QuZeTianXia/Origin-pi/README.md

# Origin-pi 

The First Attempt at Linux Development Board  
## 项目介绍 
    依托荔枝派zero和snail_card项目构建基于linux的卡片电脑。
## 更新日志 
+ 2024/3/31/10:28   
   硬件部分完成第一版，已下单嘉立创加工。着手采购器件。 ~~（这次几乎全都要买了）~~
