QuZeTianXia/Origin-pi/Hardware/PCB/Origin_pi/Origin_pi.PcbDoc.htm

Reporting Options

# File in Newer Format

Date | : | 2024/3/30
Time | : | 20:35:30
Filename | : | E:\Tech file\linux-board\Origin-pi\Hardware\PCB\Origin_pi\Origin_pi.PcbDoc

Version | Warning
Release 17.0 | CAUTION - Component parameters added.
Release 17.0 | CAUTION - Support of backdrilling
Release 17.1 | CAUTION - Support of waived violations
Release 17.1 | CAUTION - Support of object specific keepouts
Release 20.0 | CAUTION - Support of propagation delay for primitives

This file was generated by a later version of the software
