QuZeTianXia/Origin-pi/docs/f1c200s环境搭建记录.md

# 一、交叉编译环境  
> 这里使用了WSL作为开发环境，不知道会不会有什么问题   
* 需要安装交叉编译工具链
