QuZeTianXia/Origin-pi/pic/Linux.bmp

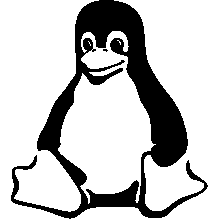
pic/Linux.bmp
