QuZeTianXia/Origin-pi/docs/BOM_SnailCard_v3s.xlsx

ID | Name | Designator | Footprint | Quantity
1 | 100nF | C13,C39,C1,C2,C3,C4,C5,C7,C8,C10,C11,C12,C21,C25,C27,C28,C29,C32,C37,C47,C52,C53,C54,C55,C56,C57,C58,C59,C30,C34 | C0603 | 30
2 | 15pF | C17,C18,C19,C20 | C0603 | 4
3 | 10uF | C22,C23,C40,C41,C6,C14,C15,C24,C31,C38,C43,C44,C45,C46,C33,C35 | C0603 | 16
4 | 1uF | C42,C9 | C0603 | 2
5 | 10K | R3,R8,R11,R29,R4,R5,R7,R12,R13,R14,R17,R19,R20,R21,R22,R24,R25,R26 | R0603 | 18
6 | 240 | R9 | R0603 | 1
7 | 6K | R15 | R0603 | 1
8 | 200K | R23,R6 | R0603 | 2
9 | ST-1185S | RSET | SW-SMD_ST-1185S | 1
10 | V3S | V3S | QUAD128 | 1
11 | 24MHz | X1 | OSC-SMD_4P-L3.2-W2.5-BL | 1
12 | 32.768KHz | X2 | OSC-SMD_L3.2-W1.5 | 1
13 | 4.7uF | C48,C16 | C0603 | 2
14 | 2.2uH | L2,L3,L4 | L0805 | 3
15 | TC5050RGBF08-3CJH-AF53A | LED | LED-SMD_6P-L5.0-W5.0-TL_TC5050RGBF08 | 1
16 | D-G080508G1 | POWER | LED0805-RD | 1
17 | TYPE-C-31-M-12 | POWER/TTL | USB-C_SMD-TYPE-C-31-M-12 | 1
18 | 2.2K | R1,R2 | R0603 | 2
19 | 680K | R10 | R0603 | 1
20 | 470 | R16,R18 | R0603 | 2
21 | 150K | R27,R28,R33,R34 | R0603 | 4
22 | 2K | R30,R35,R36 | R0603 | 3
23 | 300K | R32 | R0603 | 1
24 | XC6206-3.0V | U2 | SOT-23 | 1
25 | CH340E | U3 | MSOP-10_L3.0-W3.0-P0.50-LS5.0-BL | 1
26 | SY8088AAC | U4,U5,U8 | SOT-23-5_L3.0-W1.7-P0.95-LS2.8-BR | 3
27 | TLC-NSMD005 | U7 | R1206 | 1
28 | 1uF | C26 | CAP-SMD_L3.5-W2.8-R-RD | 1
29 | 104 | C36 | C0603 | 1
30 | CK3.5-20-1 | CN1 | AUDIO-SMD_CK3.5-20-1 | 1
31 | AN2051-245 | L1 | ANT2051 | 1
32 | 22R | R31 | R0603 | 1
33 | SD | SD2 | TF-SMD_TF-115K | 1
34 | 中景园2.0寸TFT12PIN焊接 | U1 | 中景园2.0 TFT 12PIN_0.8MM | 1
35 | RTL8723BS_Module | U12 | RTL8723BS_MODULE | 1
36 | USB-A | USB/OTG | USB-A | 1
