QuZeTianXia/Origin-pi/Hardware/Libriarys/3Ds/R0603-1.SLDPRT

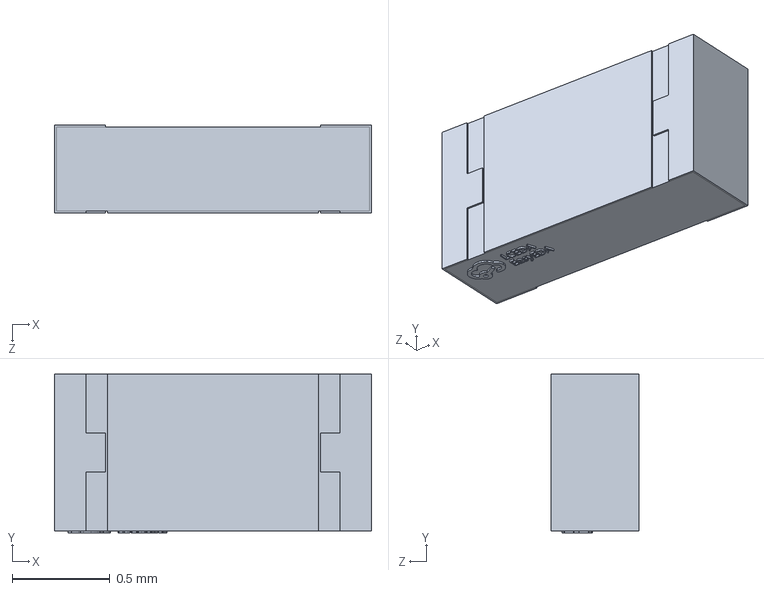
[picture p23: CAD file, 2024-03-31]
Hardware/Libriarys/3Ds/R0603-1.SLDPRT
1.62 x 0.81 x 0.45 mm
