QuZeTianXia/Origin-pi/Hardware/Libriarys/3Ds/4脚3225晶振.SLDPRT

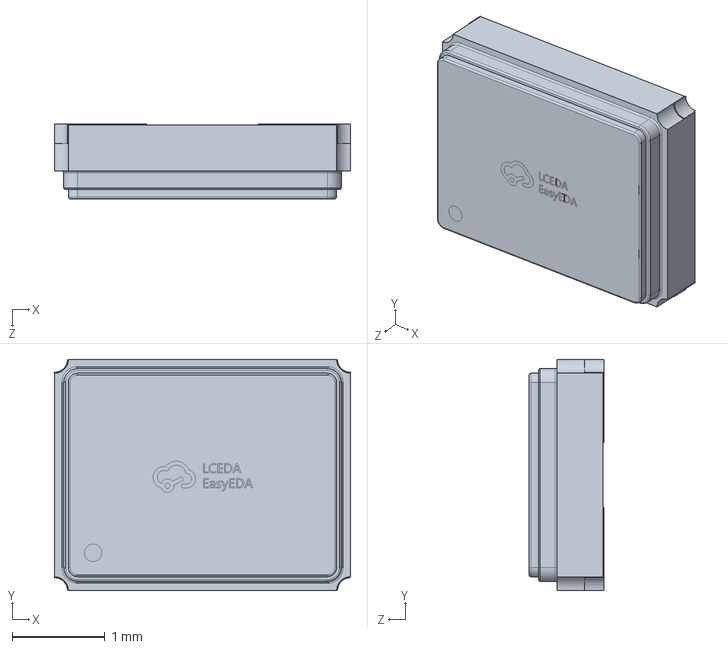
[picture p24: CAD file, 2024-03-31]
Hardware/Libriarys/3Ds/4脚3225晶振.SLDPRT
3.20 x 2.50 x 0.811 mm
