QuZeTianXia/Origin-pi/Hardware/Libriarys/3Ds/2脚3215晶振.SLDPRT

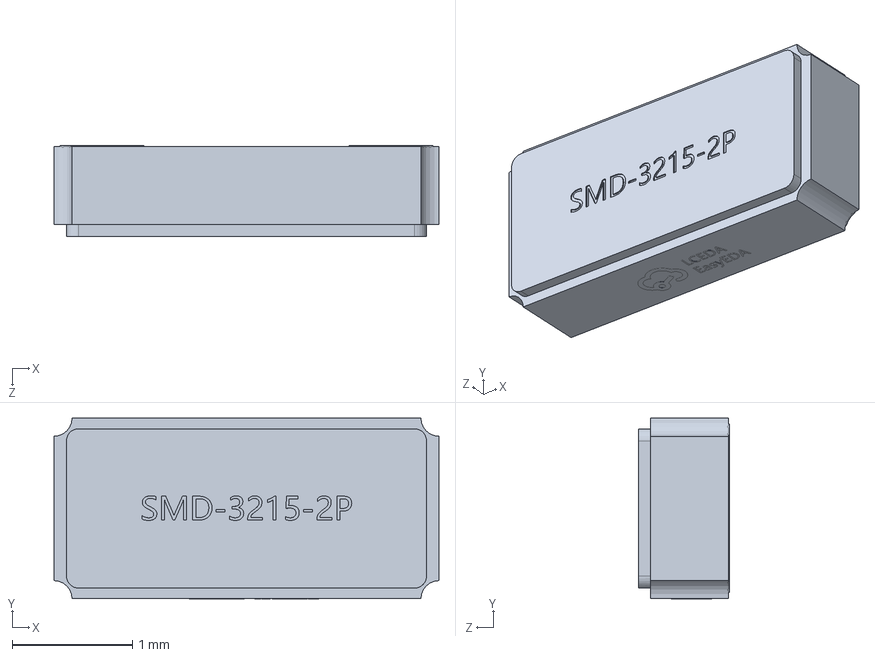
[picture p25: CAD file, 2024-03-31]
Hardware/Libriarys/3Ds/2脚3215晶振.SLDPRT
3.20 x 1.50 x 0.76 mm
