QuZeTianXia/Origin-pi/Hardware/Libriarys/3Ds/USB-Type-C-16Pin.STEP

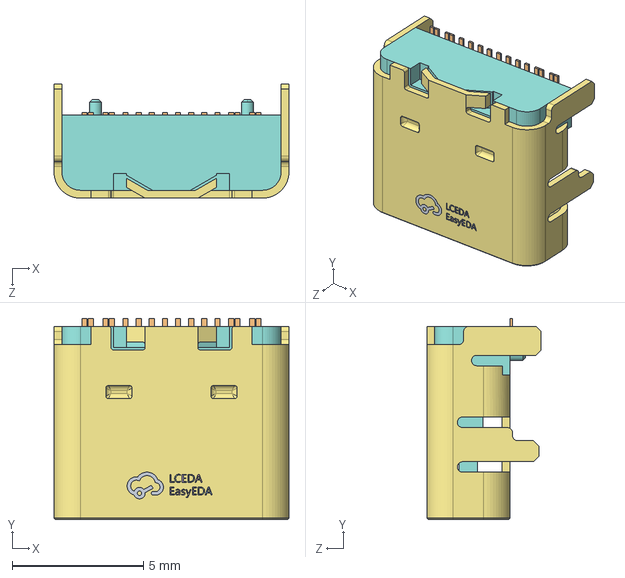
[picture p26: CAD file, 2024-03-31]
Hardware/Libriarys/3Ds/USB-Type-C-16Pin.STEP
8.94 x 7.65 x 4.35 mm
