QuZeTianXia/Origin-pi/Hardware/Libriarys/3Ds/Allwinner_V3S.SLDPRT

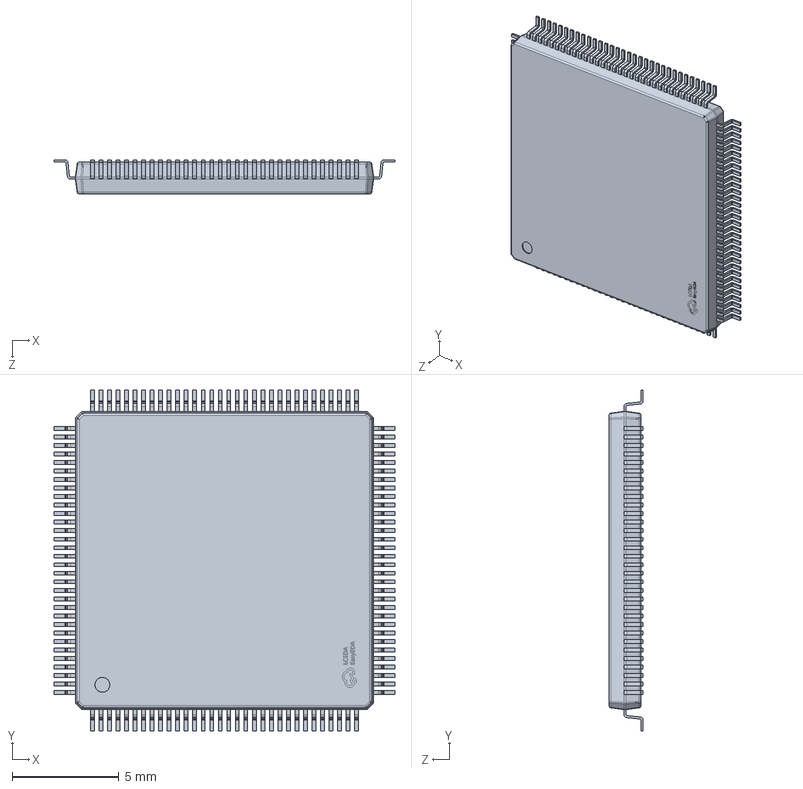
[picture p27: CAD file, 2024-03-31]
Hardware/Libriarys/3Ds/Allwinner_V3S.SLDPRT
16.0 x 16.0 x 1.61 mm
