QuZeTianXia/Origin-pi/Hardware/Libriarys/3Ds/CH340E.SLDPRT

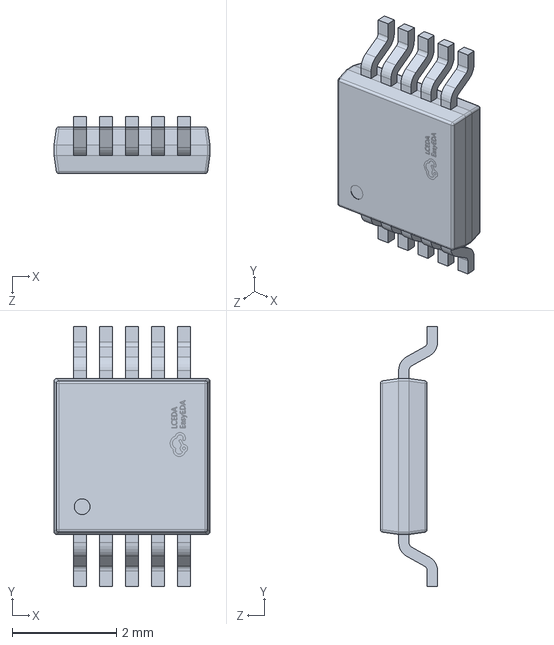
[picture p28: CAD file, 2024-03-31]
Hardware/Libriarys/3Ds/CH340E.SLDPRT
3.00 x 5.00 x 1.10 mm
