QuZeTianXia/Origin-pi/Hardware/Libriarys/3Ds/C0603.SLDPRT

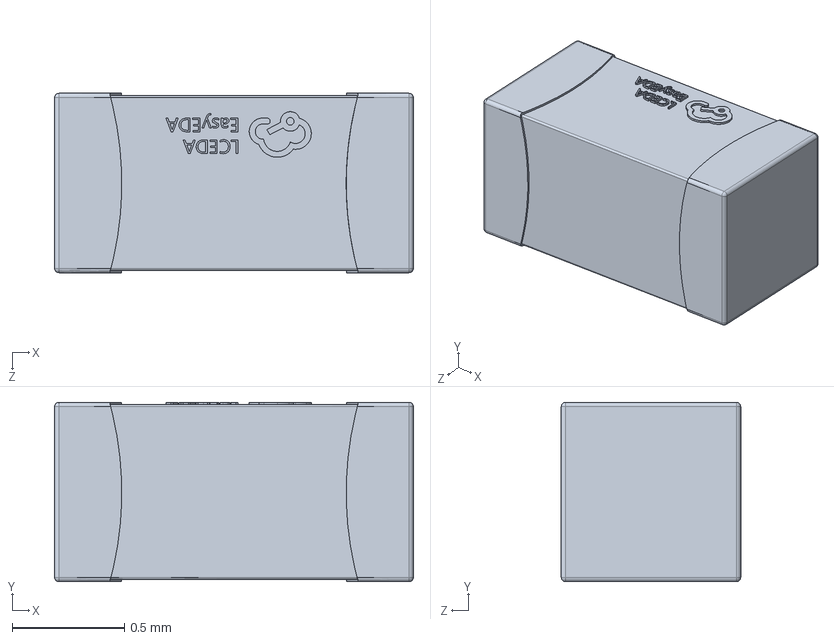
[picture p29: CAD file, 2024-03-31]
Hardware/Libriarys/3Ds/C0603.SLDPRT
1.60 x 0.8 x 0.8 mm
