QuZeTianXia/Origin-pi/Hardware/Libriarys/3Ds/USB-TYPE-C.SLDPRT

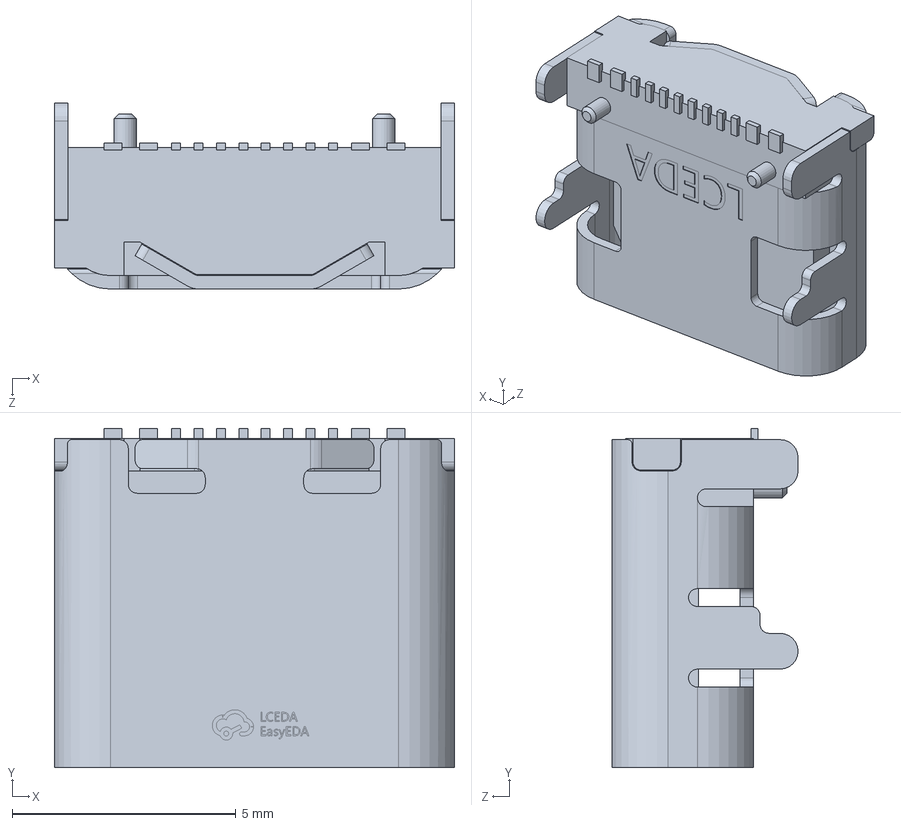
[picture p30: CAD file, 2024-03-31]
Hardware/Libriarys/3Ds/USB-TYPE-C.SLDPRT
8.94 x 7.58 x 4.16 mm
