QuZeTianXia/Origin-pi/Hardware/Libriarys/3Ds/XC6206.SLDPRT

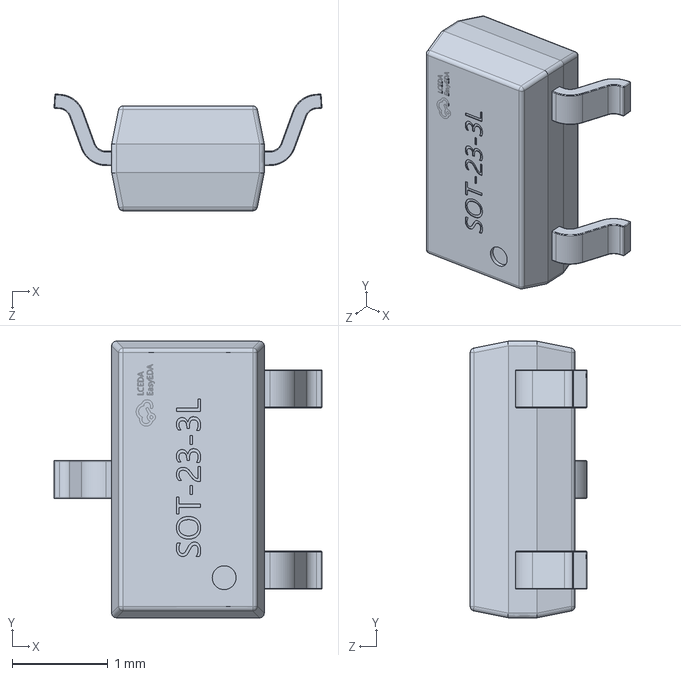
[picture p31: CAD file, 2024-03-31]
Hardware/Libriarys/3Ds/XC6206.SLDPRT
2.80 x 2.89 x 1.22 mm
