QuZeTianXia/Origin-pi/Hardware/Libriarys/3Ds/TF卡座.SLDPRT

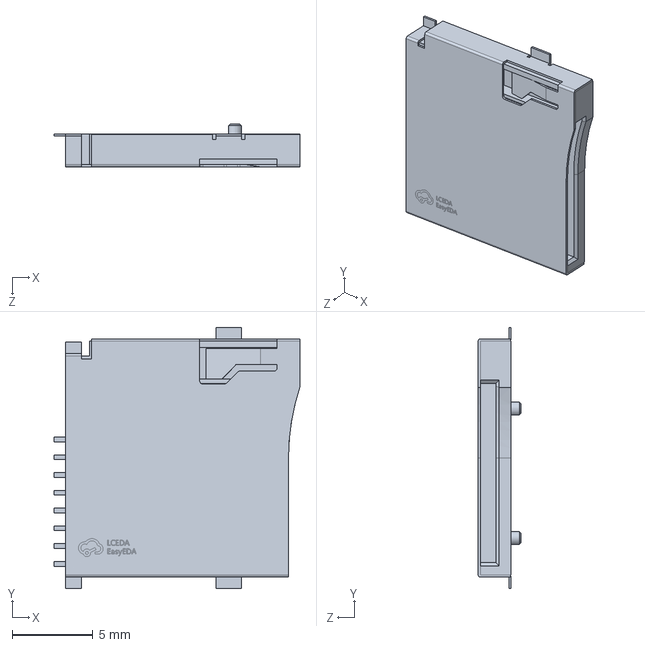
[picture p32: CAD file, 2024-03-31]
Hardware/Libriarys/3Ds/TF卡座.SLDPRT
15.2 x 16.1 x 2.65 mm
