QuZeTianXia/Origin-pi/Hardware/Libriarys/3Ds/L0603.SLDPRT

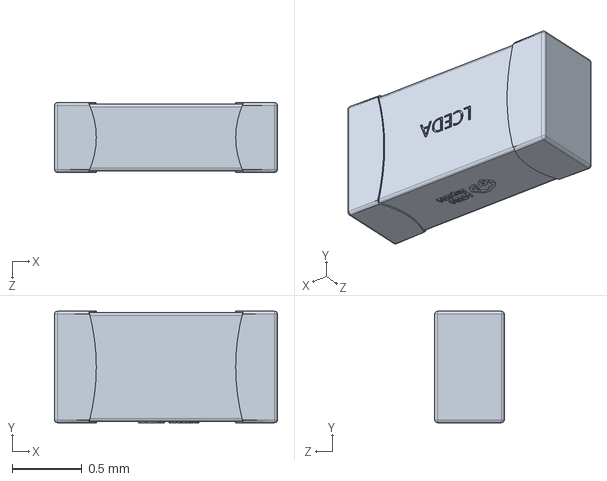
[picture p33: CAD file, 2024-03-31]
Hardware/Libriarys/3Ds/L0603.SLDPRT
1.60 x 0.8 x 0.5 mm
