QuZeTianXia/Origin-pi/Hardware/Libriarys/3Ds/SY8088AAC.SLDPRT

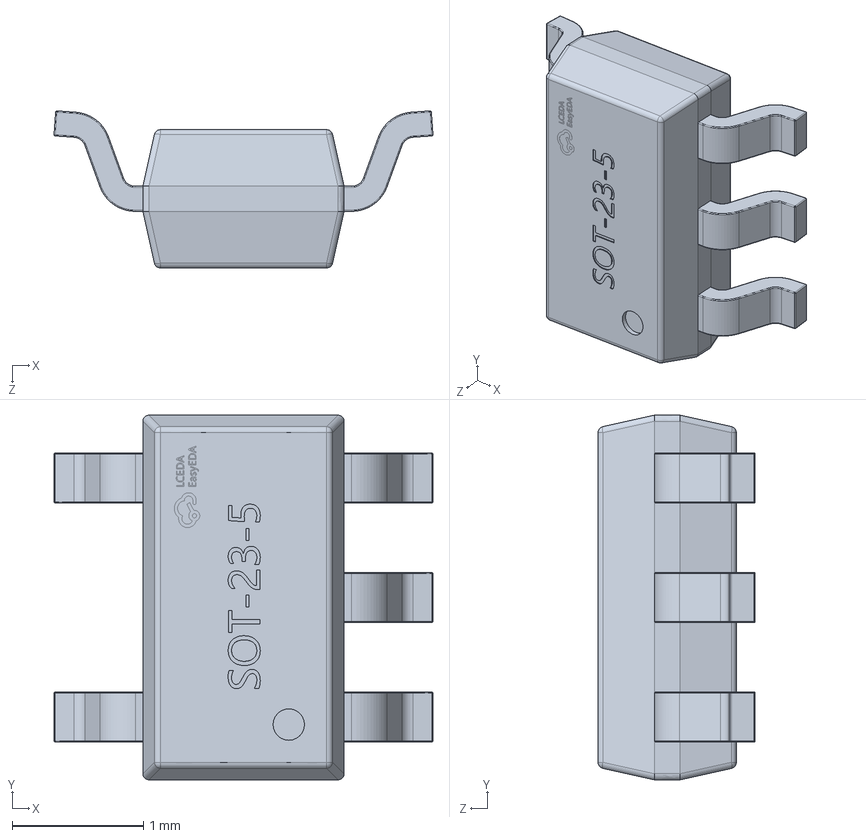
[picture p34: CAD file, 2024-03-31]
Hardware/Libriarys/3Ds/SY8088AAC.SLDPRT
2.89 x 2.78 x 1.20 mm
