QuZeTianXia/Origin-pi/Hardware/Libriarys/3Ds/3.5mm耳机接口.SLDPRT

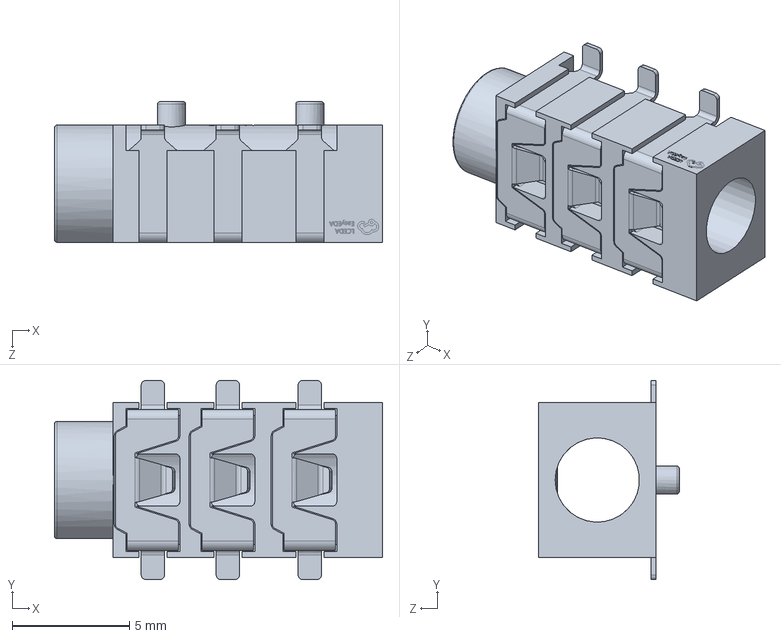
[picture p35: CAD file, 2024-03-31]
Hardware/Libriarys/3Ds/3.5mm耳机接口.SLDPRT
14.0 x 8.50 x 6.00 mm
