QuZeTianXia/Origin-pi/Hardware/Libriarys/3Ds/USB-A.SLDPRT

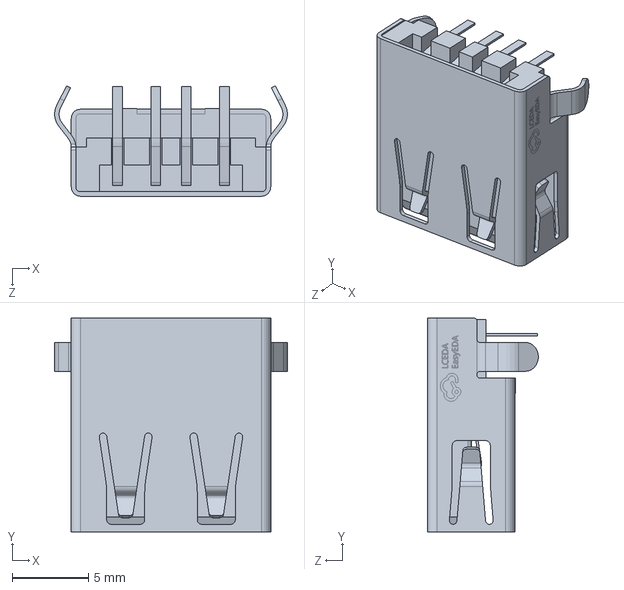
[picture p36: CAD file, 2024-03-31]
Hardware/Libriarys/3Ds/USB-A.SLDPRT
15.3 x 14.0 x 7.26 mm
