QuZeTianXia/Origin-pi/Hardware/Libriarys/3Ds/AN2051-245.SLDPRT

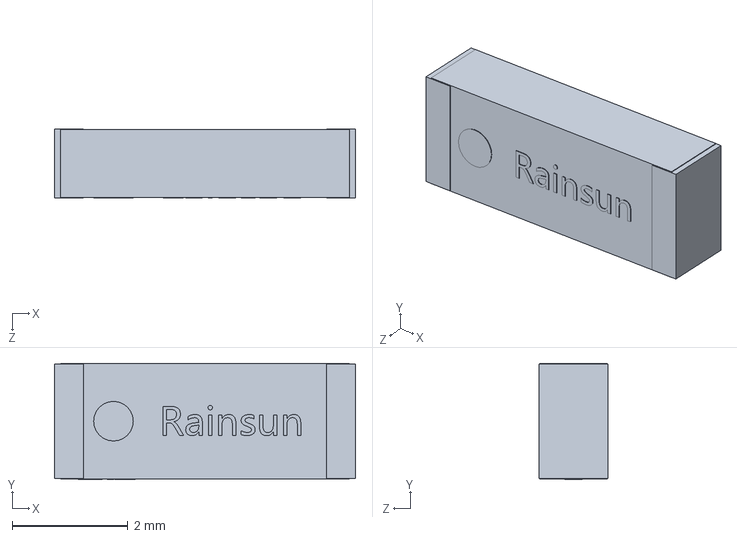
[picture p37: CAD file, 2024-03-31]
Hardware/Libriarys/3Ds/AN2051-245.SLDPRT
5.20 x 2.01 x 1.20 mm
