QuZeTianXia/Origin-pi/Hardware/Libriarys/3Ds/LED0805.SLDPRT

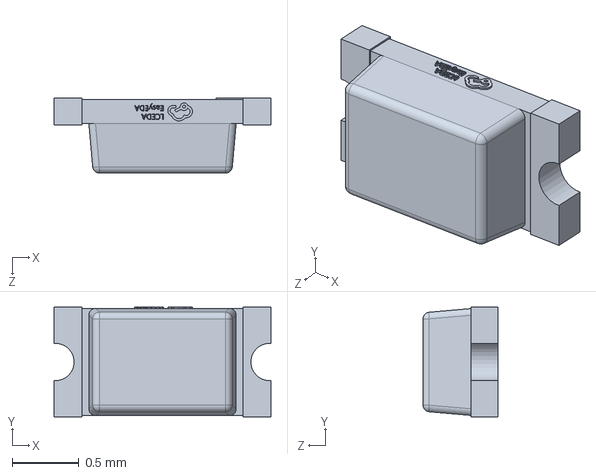
[picture p38: CAD file, 2024-03-31]
Hardware/Libriarys/3Ds/LED0805.SLDPRT
1.62 x 0.82 x 0.56 mm
