QuZeTianXia/Origin-pi/(list of files, cad)

Other CAD files:
Hardware/Libriarys/3Ds/R0603.SLDPRT
