QuZeTianXia/Origin-pi/(list of files, drawings)

Other design files:
docs/Altium_V3S-PI 基于全志V3S的随身终端_2024-02-22/V3S-PI 基于全志V3S的随身终端/Board1/PCB1.pcbdoc
docs/Altium_V3S-PI 基于全志V3S的随身终端_2024-02-22/V3S-PI 基于全志V3S的随身终端/Board1/Schematic1/1_CORE.schdoc.schdoc
docs/Altium_V3S-PI 基于全志V3S的随身终端_2024-02-22/V3S-PI 基于全志V3S的随身终端/Board1/Schematic1/2_PWR.schdoc.schdoc
docs/Altium_V3S-PI 基于全志V3S的随身终端_2024-02-22/V3S-PI 基于全志V3S的随身终端/Board1/Schematic1/3_NET.schdoc.schdoc
docs/Altium_V3S-PI 基于全志V3S的随身终端_2024-02-22/V3S-PI 基于全志V3S的随身终端/Board1/Schematic1/4_CONN.schdoc.schdoc
Hardware/Libriarys/2脚3215晶振.PcbLib
Hardware/Libriarys/2脚3215晶振.SCHLIB
Hardware/Libriarys/3.5mm耳机接口.PcbLib
Hardware/Libriarys/3.5mm耳机接口.SCHLIB
Hardware/Libriarys/4脚3225晶振.PcbLib
Hardware/Libriarys/4脚3225晶振.SCHLIB
Hardware/Libriarys/0603元件.PcbLib
Hardware/Libriarys/0603元件.SCHLIB
Hardware/Libriarys/0603电阻电容/0603电阻电容.PrjPcb
Hardware/Libriarys/0603电阻电容/C0603.PcbLib
Hardware/Libriarys/Allwinner_V3S.PcbLib
Hardware/Libriarys/Allwinner_V3S.SCHLIB
Hardware/Libriarys/AN2051-245.PcbLib
Hardware/Libriarys/AN2051-245.SCHLIB
Hardware/Libriarys/C0603.PcbLib
Hardware/Libriarys/CH340E.PcbLib
Hardware/Libriarys/CH340E.SCHLIB
Hardware/Libriarys/IPEXint1.PcbLib
Hardware/Libriarys/R0603.PcbLib
Hardware/Libriarys/RTL8723BS.PcbLib
Hardware/Libriarys/RTL8723BS.SCHLIB
Hardware/Libriarys/SY8088AAC.PcbLib
Hardware/Libriarys/SY8088AAC.SCHLIB
Hardware/Libriarys/TF卡座.PcbLib
Hardware/Libriarys/TF卡座.SCHLIB
Hardware/Libriarys/USB-A.PcbLib
Hardware/Libriarys/USB-A.SCHLIB
Hardware/Libriarys/USB-Type-C-16Pin.PcbLib
Hardware/Libriarys/USB-Type-C-16Pin.SCHLIB
Hardware/Libriarys/XC6206.PcbLib
Hardware/Libriarys/XC6206.SCHLIB
Hardware/Libriarys/中景园2寸TFT12pin-st7789v.PcbLib
Hardware/Libriarys/中景园2寸TFT12PIN-st7789v.SCHLIB
Hardware/Libriarys/贴片电阻0603.PcbLib
Hardware/Libriarys/贴片电阻0603.SCHLIB
Hardware/PCB/Origin_pi/Origin_pi.PrjPcb
Hardware/PCB/Origin_pi/Origin_pi.SchDoc
